efabless/EF_LDOR1V8/README.md

## 1. Description
*  The EF_LDOR1V8 is a positive low dropout regulator for an output of 1.8 V. It is capable of supplying 100 mA of output current with a dropout voltage of 650 mV. A low operating quiescent current of 115 µA is consumed at no load current. Moreover, it provides a standard fixed output voltage of 1.8V which is a good choice for a logic power supply. The EF_LDOR1V8 requires an output capacitance of 47 μF with a wide range of ESR (0.1 Ω to 0.5 Ω) for stability. Output capacitors of this size are typically included in most regulator designs. The functional block diagram is illustrated in Figure 1.

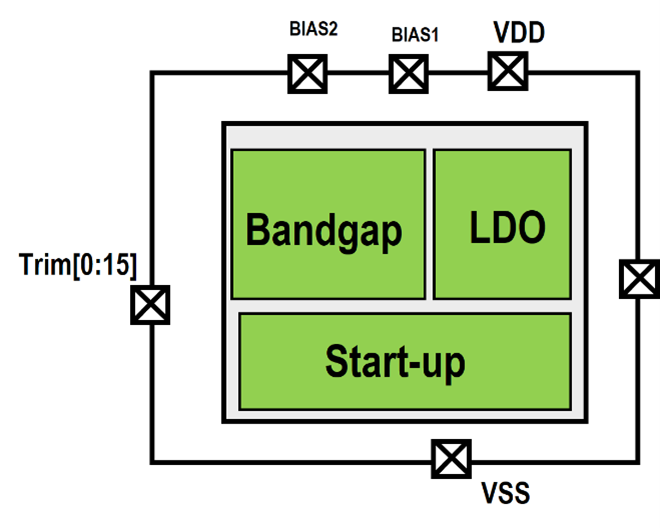
[picture p1: docs/_static/figure1.functional_block_diagram.png]


*Figure 1. Functional Block Diagram*

## 2. Features
* 100mA Output Current Capability.
* Standard Fixed Output Voltage of 1.8 V.
* Low Dropout Voltage: 650 mV at 100 mA.
* Stable with Output Capacitor of 47 µF.
  - CAP ALUM 47UF 20% 35V SMD.
* Low Supply Current of 115 µA (No Load).
* Low-Temperature Coefficient 125 ppm/°C.
* 0.016 V/V Line Regulation at 100 mA.
*	0.0083 mV/mA Load Regulation at 3.3 V.
*	Power Supply Ripple Rejection of 38.9 dB.
*	Startup time of 450 µs at rising time of 100 µs.

## 3. Applications
*	3.3V to 1.8V Logic Power Supply 

## 4. Pin Configuration and Functions

* Corresponding to the Block Diagram of the EF_LDOR1V8, each pin name with its function is described in Table 1. Moreover, a typical application of the EF_LDOR1V8 configuration is presented in Figure 2, where, Co=47µF, ESR=0.1Ω, RB1=450 KΩ, RB2=300 KΩ, and Trim[6]=3.3 V. Min RL is  18 Ω to provide Max load current of 100 mA.

*Table 1. Pin Configuration and Functions*
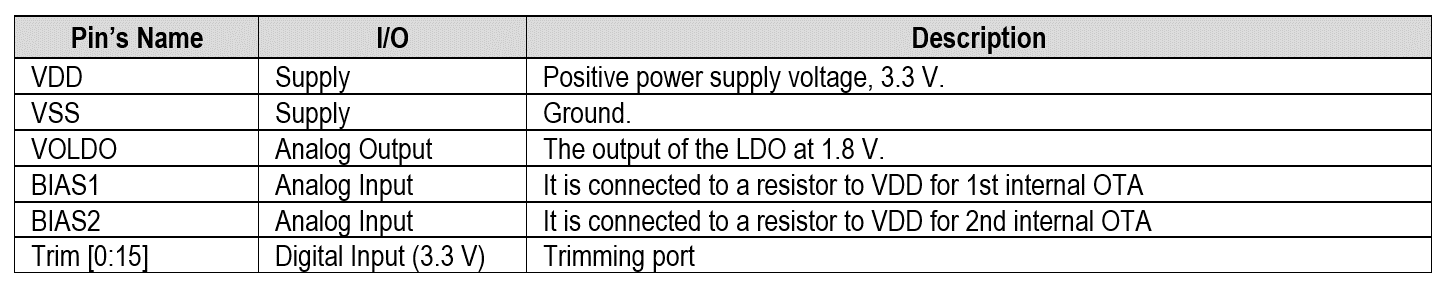
[picture p2: docs/_static/table1.png]


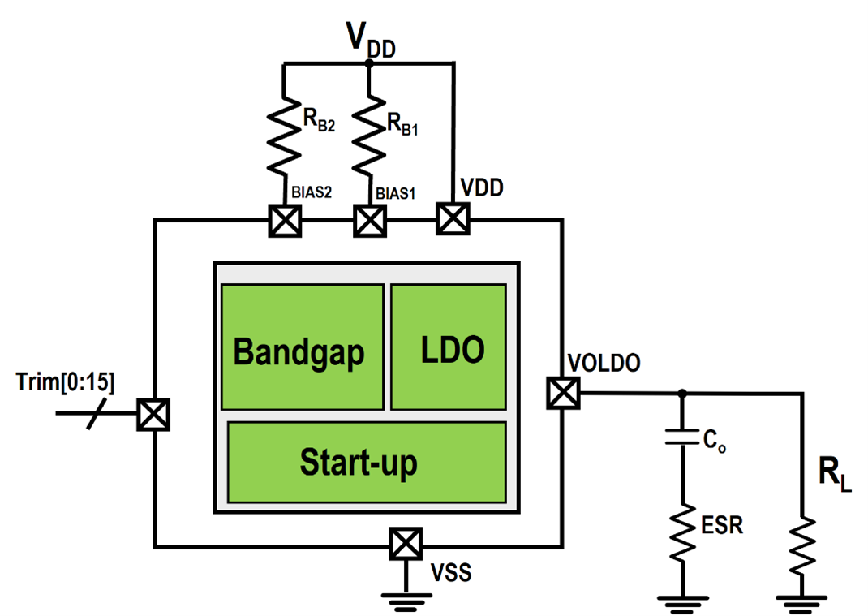
[picture p3: docs/_static/figure2.typical_application.png]


*Figure 2. Typical Application*

## 5. Electrical Characteristics

* The post-layout simulation results of the proposed EF_LDOR1V8 are listed in Table 2. Those parameters are reported at Temp.=27°C,Co=47µF, ESR=0.1Ω, RB1=450 KΩ, RB2=300 KΩ, Trim[6]=3.3 V. 

*Table 2. Electrical Characteristics*
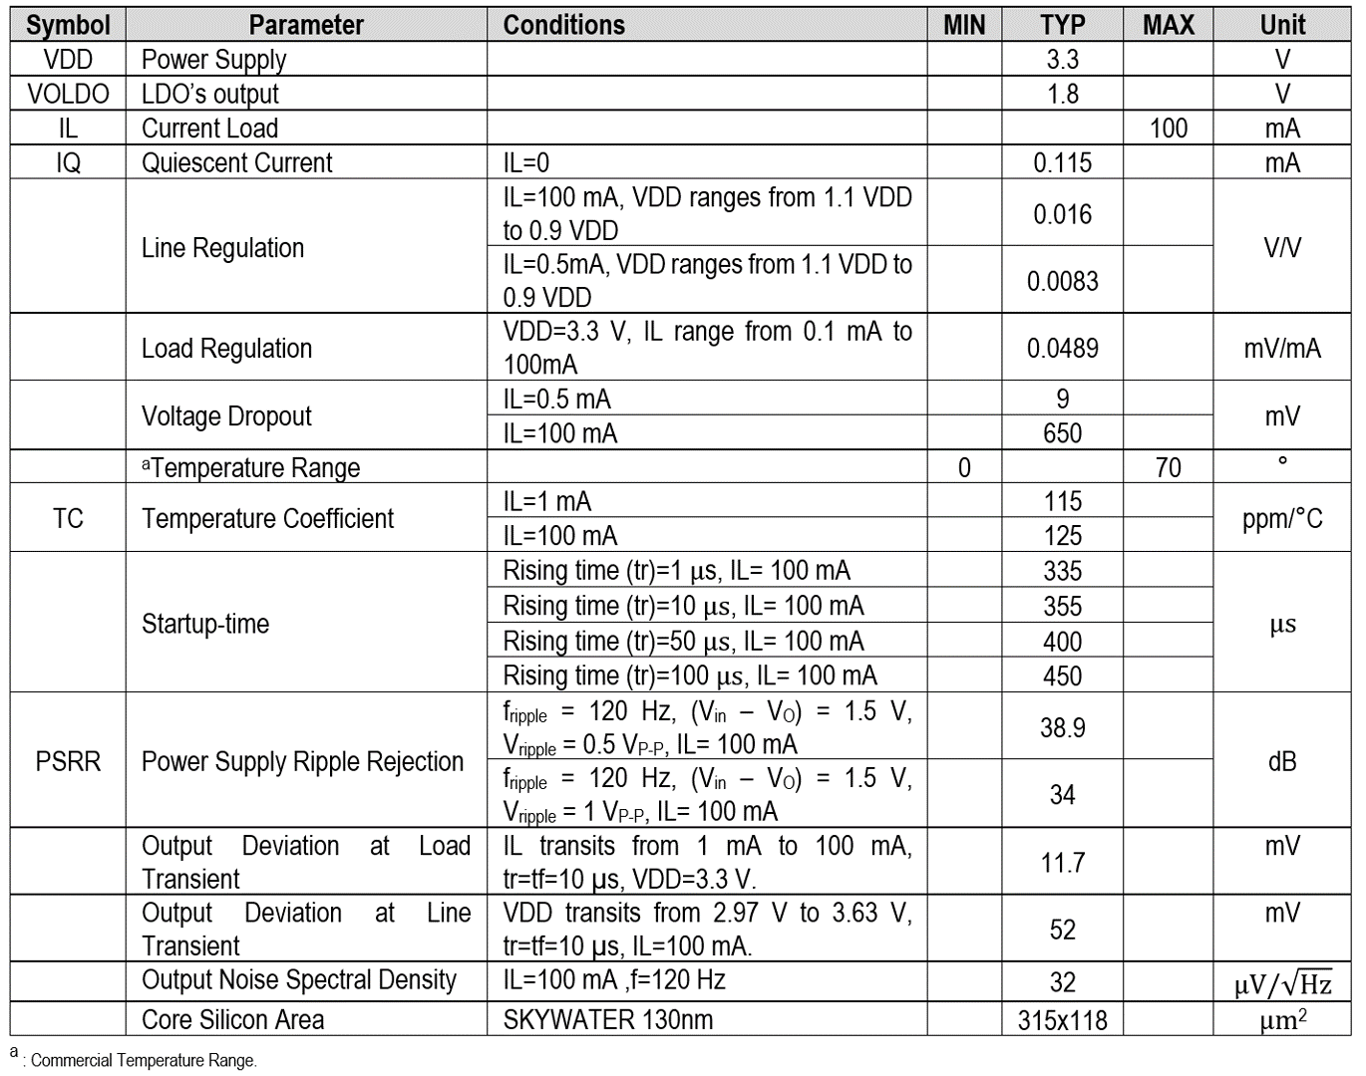
[picture p4: docs/_static/table2.png]


## 6. Typical Performance Curves

* The proposed EF_LDOR1V8 has been designed and simulated using open-source tools with SkyWater technology. Herein, [XSCHEM](https://xschem.sourceforge.io/stefan/index.html) is a schematic capture program that provides a graphical method of the electronic schematic circuit, easily. [NGSPICE](http://ngspice.sourceforge.net/download.html) is an open-source spice simulator. It is exploited to simulate and verify the designed circuit. The layout of the EF_DACR0801 is implemented using [MAGIC 8.3](http://opencircuitdesign.com/magic/) and for design rule check (DRC) as well. However, [NETGEN](http://opencircuitdesign.com/netgen/) is used for comparing netlists of the layout and schematic, known as layout vs schematic (LVS). [PYTHON](https://www.python.org/) can be integrated with the NGSPICE simulator for data manipulation/analysis of the simulation result.

#### Next, typical performance curves of the EF_LDOR1V8 post-layout simulations are presented. 

* As depicted in Figure 3 (a), EF_LDOR1V8's output is plotted by sweeping the input voltage from 0V to 5V at different levels of load currents. Besides, the dropout voltages are calculated at different levels of load currents, then plotted as shown in Figure 3 (b). In Figure 4, Output Voltage vs Input Voltage and Line Regulation vs Load Current are illustrated. Load Regulation can be measured using Figure 5. Startup time and Temperature Coefficient are calculated as shown in Figures 6 and 7, respectively. 

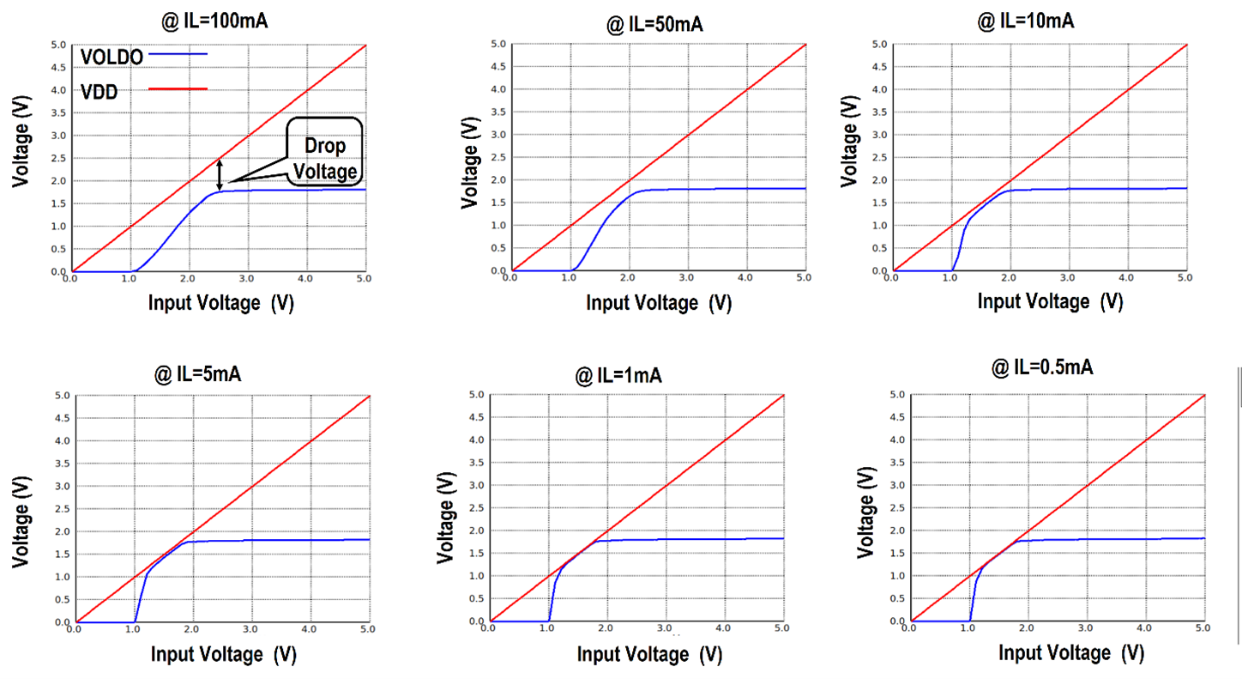
[picture p5: docs/_static/figure3.(a) Output Voltage vs Input Voltage.png]


(a)

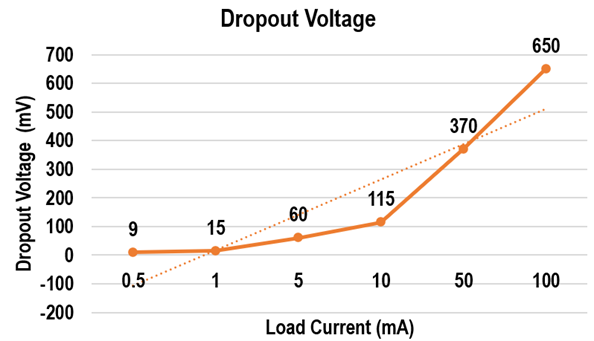
[picture p6: docs/_static/figure3. (b)dropout_voltage_ vs_load current..png]


(b)

*Figure 3. (a) Output Voltage vs Input Voltage, (b) Dropout Voltage vs Load Current.*
 
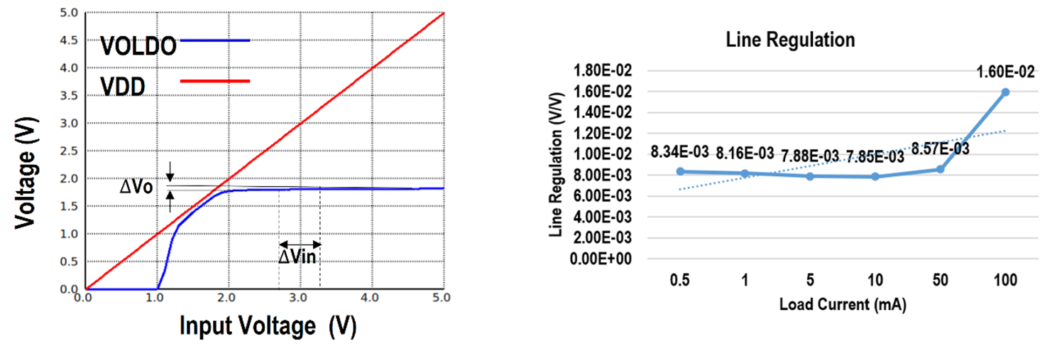
[picture p7: docs/_static/figure4. (a) output-voltage_vs_Input_voltage(b)line_regulation_vs_load_current..png]


                       (a)                                            (b)
                       
*Figure 4. (a) Output Voltage vs Input Voltage, (b) Line Regulation vs Load Current.*

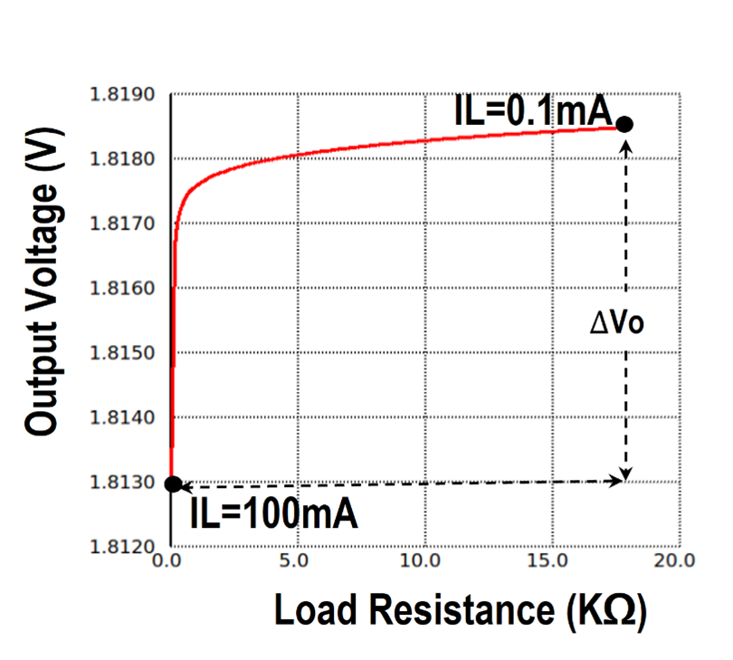
[picture p8: docs/_static/figure 5.output_voltage_vs_load_resistance.png]


*Figure 5.  Output Voltage vs Load Resistance at VDD=3.3V*

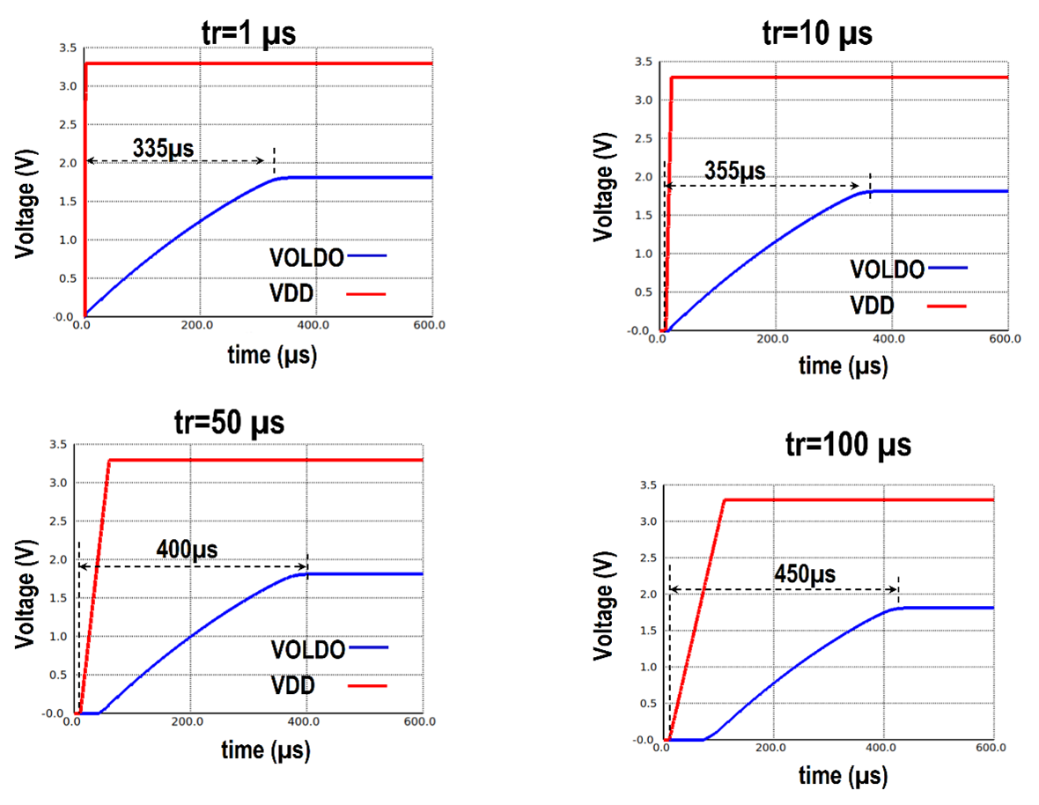
[picture p9: docs/_static/figure6. startup_time.png]


*Figure 6. Startup time at different rising time of input voltage Il=100 mA.*

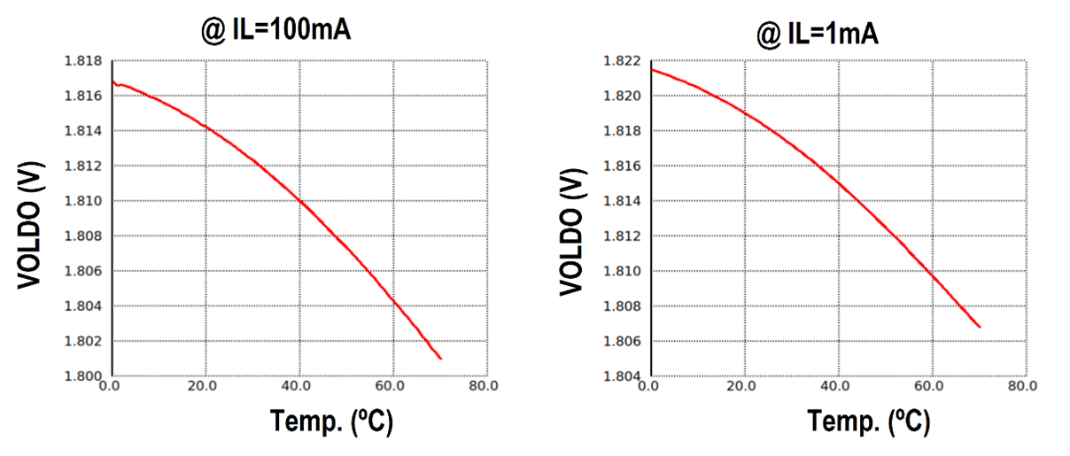
[picture p10: docs/_static/figure7. temperature_coefficient.png]


*Figure 7. Temperature Coefficient of the output voltage at (a) IL=100 mA, and (b) IL=1 mA*

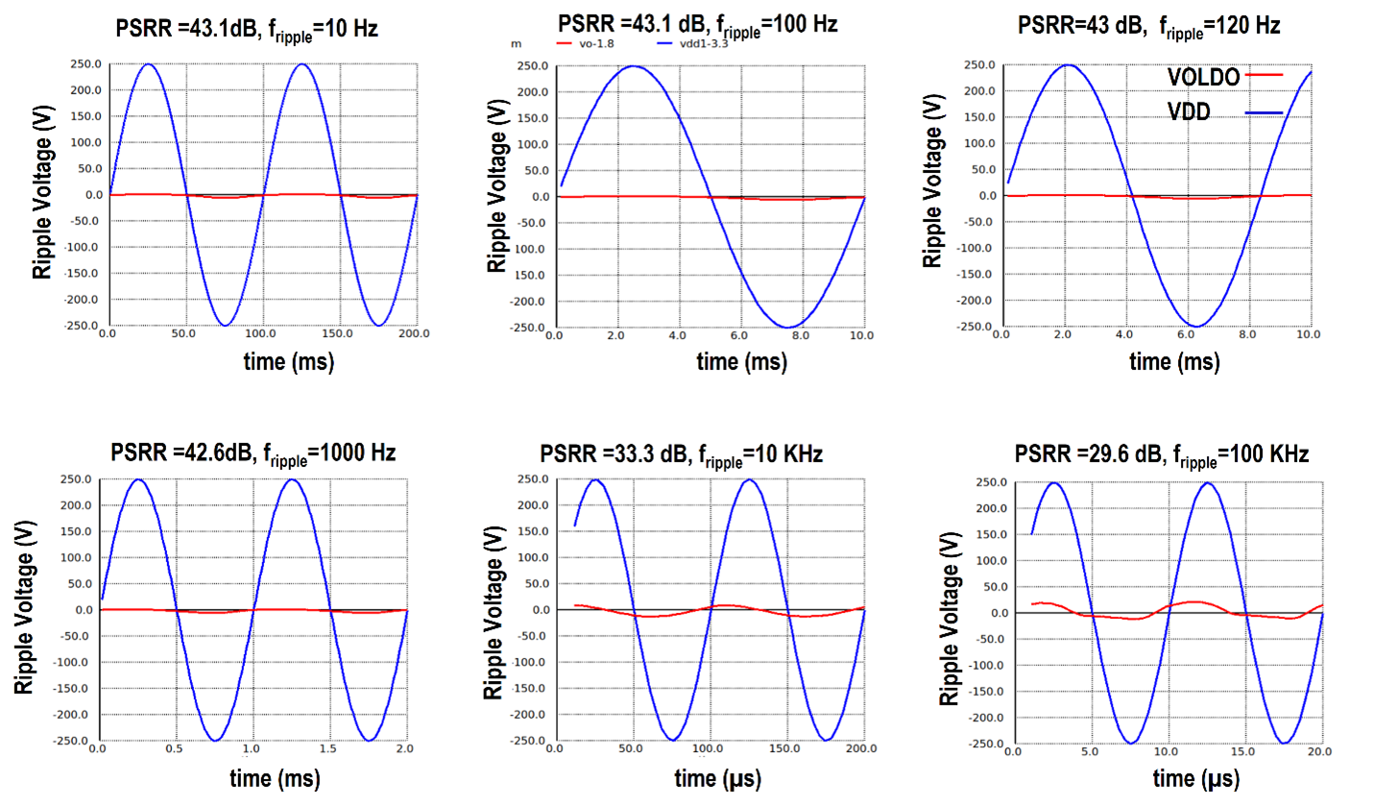
[picture p11: docs/_static/figure 8.ripple_voltage.png]


(a)

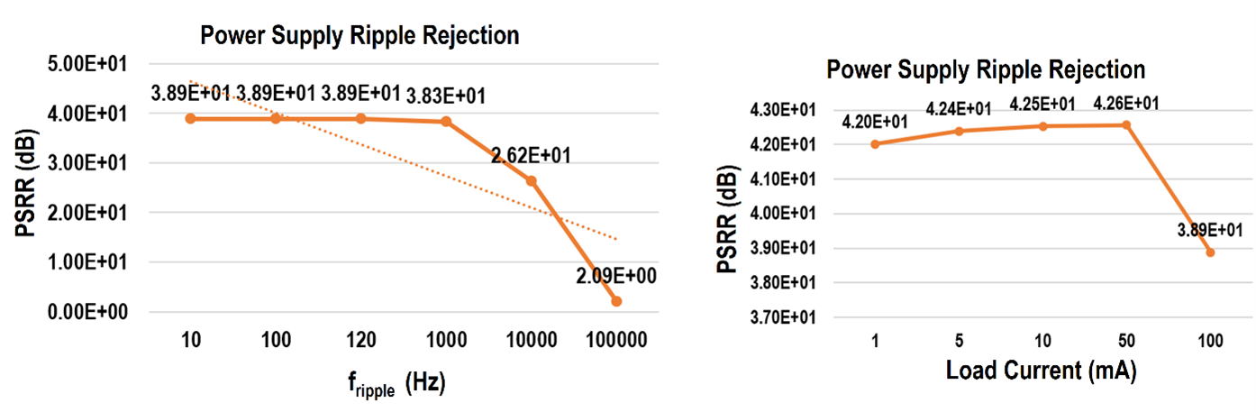
[picture p12: docs/_static/figure8. (b)psrr_vs_frequency (c)psrr_load_current.png]


                       (b)                                            (c)

*Figure 8. (a) Ripple Voltage at Vp-p=0.5 V , (b) PSRR vs Frequency at IL=100 mA, (c) PSRR Vs Load current at fripple=120 Hz and Vp-p=0.5 V*

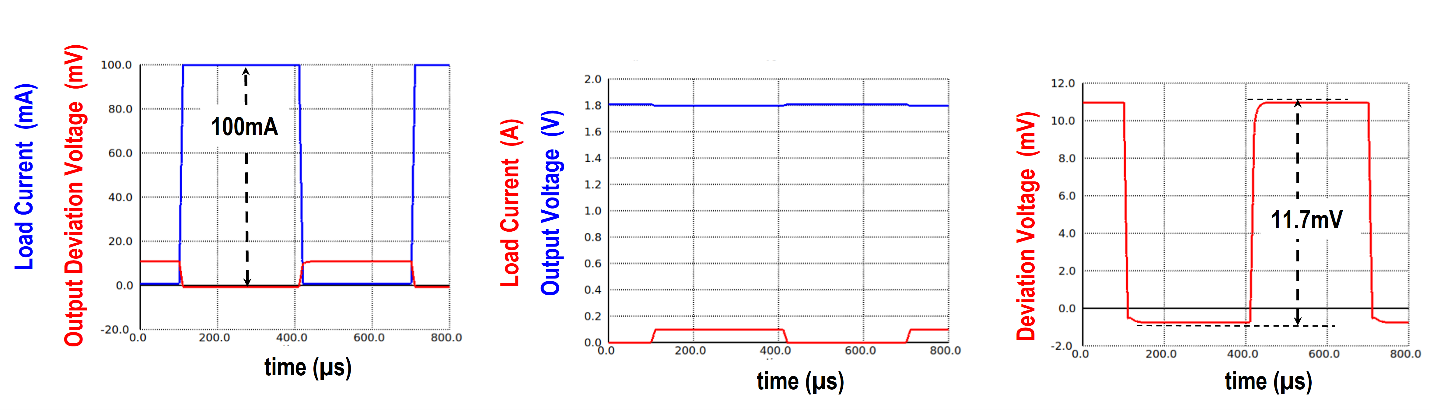
[picture p13: docs/_static/figure 9.load_transient_response.png]


*Figure 9. Load Transient Response at VDD of 3.3 V (tr=tf=10μs).*

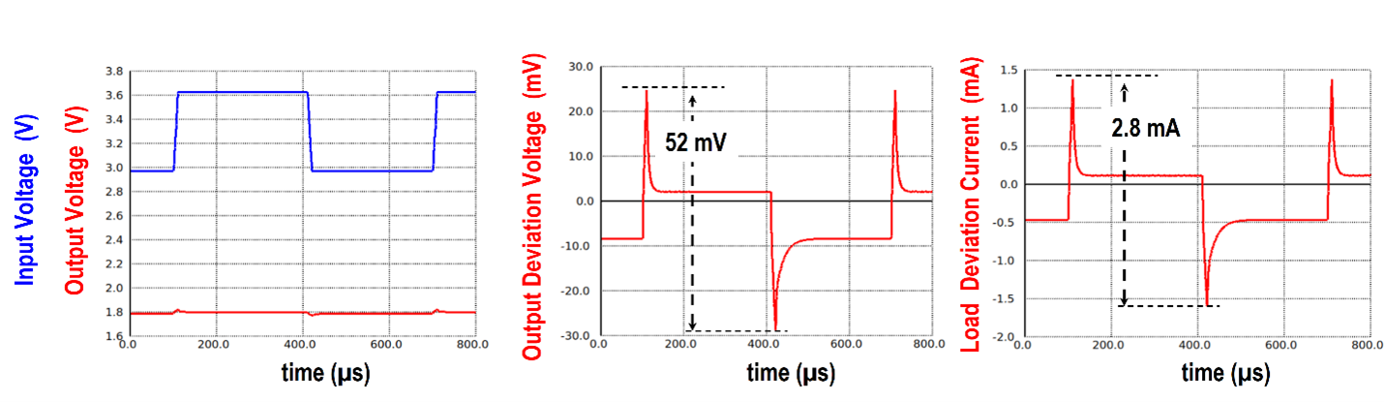
[picture p14: docs/_static/figure10.line_transient_response.png]


*Figure 10. Line Transient Response at IL of 100 mA and VDD transits from 2.97 V to 3.63 V.*

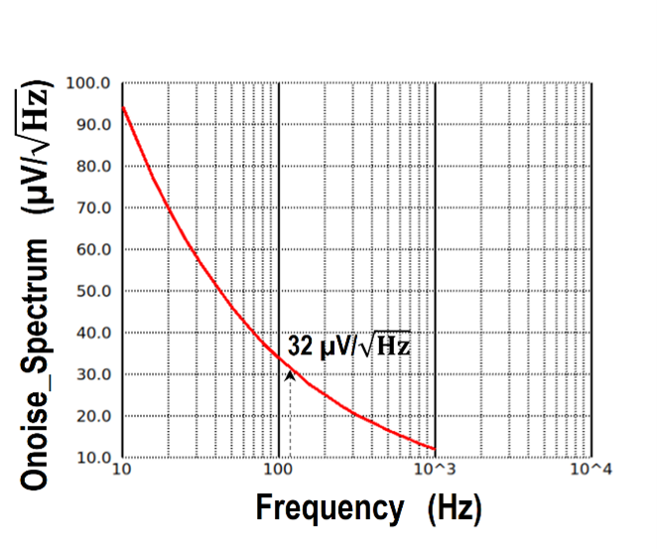
[picture p15: docs/_static/figure 11.output_noise_spectrum.png]


*Figure 11. Output Noise Spectrum*

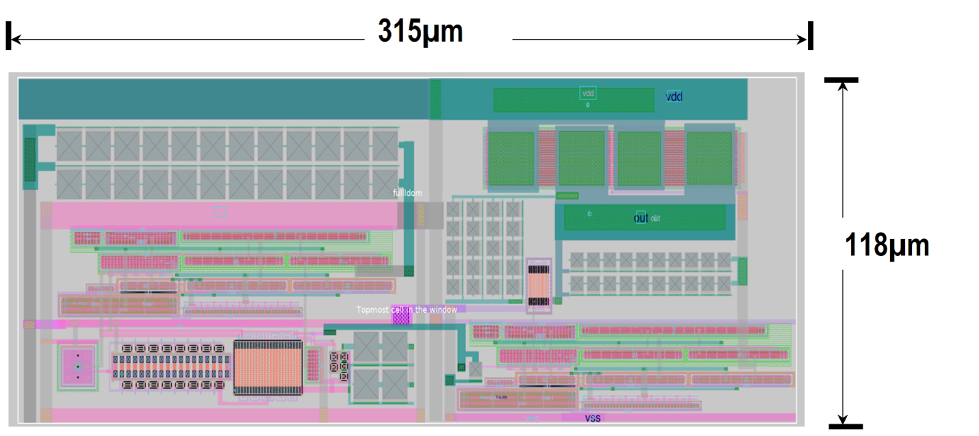
[picture p16: docs/_static/figure12.full_regulator_layout.png]


*Figure 12. Full Regulator Layout*

## 7. Downloading the files on your System
<p>&nbsp;</p>

* The files from this repository can be downloaded and used by the following commands:-
>`sudo apt install -y git`

>`git clone https://github.com/Ahmedredamohamed2022/EF_LDOR01.git`

<p>&nbsp;</p>
