efabless/EF_LDOR1V8/spice/readme.md

* Here, lvs folder contains two spice files:
  - The extracted spice file from the layout titled "EF_LDOR01f.spice" 
  - The extracted spice file from the XSCHEM  titled "EF_LDOR01f.spice" 
* In the post_layout folder, the extracted spice file from the layout with RC is attached.
* In the pre_layout folder, the extracted spice file from the XSCHEM  is included.
