efabless/EF_LDOR1V8/characterization/temperature_coefficient/readme.md

## To run the temperature coefficient testbench using the follwing steps:-
* Open terminal window
* Write the next command 
<p>&nbsp;</p>

>`ngspice tc.spice`

<p>&nbsp;</p>
