efabless/EF_LDOR1V8/characterization/startup/readme.md

## To run the start_up testbench using the follwing steps:-
* Open terminal window
* Write the next command 
<p>&nbsp;</p>

>`ngspice startup.spice`

<p>&nbsp;</p>
