efabless/EF_LDOR1V8/characterization/power_suppy_ripple_rejection/readme.md

## To run the PSRR testbench using the follwing steps:-
* Open terminal window
* Write the next command 
<p>&nbsp;</p>

>`ngspice psrr.spice`

<p>&nbsp;</p>
