efabless/EF_LDOR1V8/characterization/noise/readme.md

## To run the noise testbench using the follwing steps:-
* Open terminal window
* Write the next command 
<p>&nbsp;</p>

>`ngspice noise.spice`

<p>&nbsp;</p>
