efabless/EF_LDOR1V8/characterization/load_transient/readme.md

## To run the load_transient testbench using the follwing steps:-
* Open terminal window
* Write the next command 
<p>&nbsp;</p>

>`ngspice load_trans.spice`

<p>&nbsp;</p>
