efabless/EF_LDOR1V8/characterization/line_transient/readme.md

## To run the line_transient testbench using the follwing steps:-
* Open terminal window
* Write the next command 
<p>&nbsp;</p>

>`ngspice line_trans.spice`

<p>&nbsp;</p>
