efabless/EF_LDOR1V8/verification/load_regulation/loadreg.spice

** sch_path: /home/ahmedreda/Project/AR_BGR/testbench/full_ldo/fullldox_v2-tb/loadreg.sch
**.subckt loadreg
vdd1 vdd1 vss 3.3
.save i(vdd1)
vss2 vss GND 0
.save i(vss2)
Vbias net1 biasbgr 0
.save i(vbias)
vtot vdd1 vdd 0
.save i(vtot)
R3 net4 vdd 300000 m=1
C3 vo net2 47u m=1
R4 net2 vss 0.1 m=1
Vl net3 vss 0
.save i(vl)
Vbiasldo net4 biasldo 0
.save i(vbiasldo)
R2 net1 vdd 450000 m=1
x1 vss vss vss vss vss vss vss vss vss vdd vss vss vss vss vss vss vss biasbgr vdd biasldo vo
+ fullldoxcc
R1 vo net3 0.1 m=1
**** begin user architecture code



.options RSHUNT=1e15
.options savecurrents
.option TEMP=27
.option TNOM=27

.control
**set filetype=binary
set filetype=ascii
set color0=white
set color1=black
set color3=blue
set xbrushwidth=3
run
save all
dc R1 18 18000 100
plot vo vdd vbg
plot vo
plot vbg
meas DC vo1 FIND vo AT=18
meas DC vo2 FIND vo AT=1800
let loadReg= mag(vo1-vo2)*1000/99
print loadReg


.endc





.lib /home/ahmedreda/PDK/sky130A/libs.tech/ngspice/sky130.lib.spice tt


**** end user architecture code
**.ends

* expanding   symbol:  Project/AR_BGR/schematic/fullldo/fullldoxcc.sym # of pins=6
** sym_path: /home/ahmedreda/Project/AR_BGR/schematic/fullldo/fullldoxcc.sym
** sch_path: /home/ahmedreda/Project/AR_BGR/schematic/fullldo/fullldoxcc.sch
.subckt fullldoxcc trim[15] trim[14] trim[13] trim[12] trim[11] trim[10] trim[9] trim[8] trim[7]
+ trim[6] trim[5] trim[4] trim[3] trim[2] trim[1] trim[0] vss biasbgr vdd biasldo out
*.iopin vss
*.iopin vdd
*.ipin biasldo
*.opin out
*.ipin biasbgr
*.ipin
*+ trim[15],trim[14],trim[13],trim[12],trim[11],trim[10],trim[9],trim[8],trim[7],trim[6],trim[5],trim[4],trim[3],trim[2],trim[1],trim[0]
x1 vss vdd biasldo vref out ldoxc
x2 vdd vref vss biasbgr trim[15] trim[14] trim[13] trim[12] trim[11] trim[10] trim[9] trim[8]
+ trim[7] trim[6] trim[5] trim[4] trim[3] trim[2] trim[1] trim[0] gate bandgapxd
XC2 gate vss sky130_fd_pr__cap_mim_m3_1 W=10 L=10 MF=24 m=24
XC1 vref vss sky130_fd_pr__cap_mim_m3_1 W=5 L=5 MF=1 m=1
.ends


* expanding   symbol:  Project/AR_BGR/schematic/ldo_core/ldoxc.sym # of pins=5
** sym_path: /home/ahmedreda/Project/AR_BGR/schematic/ldo_core/ldoxc.sym
** sch_path: /home/ahmedreda/Project/AR_BGR/schematic/ldo_core/ldoxc.sch
.subckt ldoxc vss vdd bias vref out
*.opin out
*.ipin bias
*.iopin vss
*.iopin vdd
*.ipin vref
x3 vdd vg out pmosx
x1 vdd vg vref fbdiv bias vss otaldox
x2 out vss fbdiv vdx
XC4 vg out sky130_fd_pr__cap_mim_m3_1 W=5 L=5 MF=20 m=20
XC5 out fbdiv sky130_fd_pr__cap_mim_m3_1 W=5 L=5 MF=20 m=20
.ends


* expanding   symbol:  Project/AR_BGR/schematic/bandgap_core/bandgapxd.sym # of pins=6
** sym_path: /home/ahmedreda/Project/AR_BGR/schematic/bandgap_core/bandgapxd.sym
** sch_path: /home/ahmedreda/Project/AR_BGR/schematic/bandgap_core/bandgapxd.sch
.subckt bandgapxd vdd vbg vss bias trim[15] trim[14] trim[13] trim[12] trim[11] trim[10] trim[9]
+ trim[8] trim[7] trim[6] trim[5] trim[4] trim[3] trim[2] trim[1] trim[0] gate
*.opin vbg
*.ipin bias
*.ipin
*+ trim[15],trim[14],trim[13],trim[12],trim[11],trim[10],trim[9],trim[8],trim[7],trim[6],trim[5],trim[4],trim[3],trim[2],trim[1],trim[0]
*.iopin vdd
*.iopin vss
*.opin gate
XM12 comp gate vdd vdd sky130_fd_pr__pfet_g5v0d10v5 L=1 W=4 nf=1 ad='int((nf+1)/2) * W/nf * 0.29' as='int((nf+2)/2) * W/nf * 0.29'
+ pd='2*int((nf+1)/2) * (W/nf + 0.29)' ps='2*int((nf+2)/2) * (W/nf + 0.29)' nrd='0.29 / W' nrs='0.29 / W'
+ sa=0 sb=0 sd=0 mult=2 m=2
XM1 vbg gate vdd vdd sky130_fd_pr__pfet_g5v0d10v5 L=1 W=4 nf=1 ad='int((nf+1)/2) * W/nf * 0.29' as='int((nf+2)/2) * W/nf * 0.29'
+ pd='2*int((nf+1)/2) * (W/nf + 0.29)' ps='2*int((nf+2)/2) * (W/nf + 0.29)' nrd='0.29 / W' nrs='0.29 / W'
+ sa=0 sb=0 sd=0 mult=2 m=2
XM2 vs2 vs2 vdd vdd sky130_fd_pr__pfet_g5v0d10v5 L=1 W=1 nf=1 ad='int((nf+1)/2) * W/nf * 0.29' as='int((nf+2)/2) * W/nf * 0.29'
+ pd='2*int((nf+1)/2) * (W/nf + 0.29)' ps='2*int((nf+2)/2) * (W/nf + 0.29)' nrd='0.29 / W' nrs='0.29 / W'
+ sa=0 sb=0 sd=0 mult=1 m=1
XM6 vss vdd vs2 vdd sky130_fd_pr__pfet_g5v0d10v5 L=1 W=1 nf=1 ad='int((nf+1)/2) * W/nf * 0.29' as='int((nf+2)/2) * W/nf * 0.29'
+ pd='2*int((nf+1)/2) * (W/nf + 0.29)' ps='2*int((nf+2)/2) * (W/nf + 0.29)' nrd='0.29 / W' nrs='0.29 / W'
+ sa=0 sb=0 sd=0 mult=1 m=1
XC2 vs2 vss sky130_fd_pr__cap_mim_m3_1 W=10 L=10 MF=4 m=4
XM3 vs1 vbg vss vss sky130_fd_pr__nfet_g5v0d10v5 L=1 W=1 nf=1 ad='int((nf+1)/2) * W/nf * 0.29' as='int((nf+2)/2) * W/nf * 0.29'
+ pd='2*int((nf+1)/2) * (W/nf + 0.29)' ps='2*int((nf+2)/2) * (W/nf + 0.29)' nrd='0.29 / W' nrs='0.29 / W'
+ sa=0 sb=0 sd=0 mult=1 m=1
XM4 gate vs1 vss vss sky130_fd_pr__nfet_g5v0d10v5 L=1 W=1 nf=1 ad='int((nf+1)/2) * W/nf * 0.29' as='int((nf+2)/2) * W/nf * 0.29'
+ pd='2*int((nf+1)/2) * (W/nf + 0.29)' ps='2*int((nf+2)/2) * (W/nf + 0.29)' nrd='0.29 / W' nrs='0.29 / W'
+ sa=0 sb=0 sd=0 mult=1 m=1
x2 vbg comp vp vn vss bg_res
x3 trimup veg trim[15] trim[14] trim[13] trim[12] trim[11] trim[10] trim[9] trim[8] trim[7] trim[6]
+ trim[5] trim[4] trim[3] trim[2] trim[1] trim[0] vss bg_trim
XQ1 vss vss vn sky130_fd_pr__pnp_05v5_W0p68L0p68 m=1
XQ2 vss vss veg sky130_fd_pr__pnp_05v5_W0p68L0p68 m=8
x7 vdd gate vp vn vss bias ota
XR2 trimup vp vss sky130_fd_pr__res_xhigh_po_0p69 L=13 mult=1 m=1
XM7 vdd vdd vdd vdd sky130_fd_pr__pfet_g5v0d10v5 L=1 W=4 nf=1 ad='int((nf+1)/2) * W/nf * 0.29' as='int((nf+2)/2) * W/nf * 0.29'
+ pd='2*int((nf+1)/2) * (W/nf + 0.29)' ps='2*int((nf+2)/2) * (W/nf + 0.29)' nrd='0.29 / W' nrs='0.29 / W'
+ sa=0 sb=0 sd=0 mult=4 m=4
XR17 vss vss vss sky130_fd_pr__res_high_po W=1.41 L=2.8 mult=1 m=1
XR18 vss vss vss sky130_fd_pr__res_high_po W=1.41 L=2.8 mult=1 m=1
XR21 vss vss vss sky130_fd_pr__res_xhigh_po_0p69 L=13 mult=1 m=1
XR23 vss vss vss sky130_fd_pr__res_xhigh_po_0p69 L=13 mult=1 m=1
XM5 vs1 vs2 vdd vdd sky130_fd_pr__pfet_g5v0d10v5 L=1 W=1 nf=1 ad='int((nf+1)/2) * W/nf * 0.29' as='int((nf+2)/2) * W/nf * 0.29'
+ pd='2*int((nf+1)/2) * (W/nf + 0.29)' ps='2*int((nf+2)/2) * (W/nf + 0.29)' nrd='0.29 / W' nrs='0.29 / W'
+ sa=0 sb=0 sd=0 mult=1 m=1
.ends


* expanding   symbol:  Project/AR_BGR/schematic/ldo_core/pmosx.sym # of pins=3
** sym_path: /home/ahmedreda/Project/AR_BGR/schematic/ldo_core/pmosx.sym
** sch_path: /home/ahmedreda/Project/AR_BGR/schematic/ldo_core/pmosx.sch
.subckt pmosx vdd vg vout
*.opin vout
*.iopin vdd
*.ipin vg
XM8 vout vg vdd vdd sky130_fd_pr__pfet_g5v0d10v5 L=0.5 W=50 nf=1 ad='int((nf+1)/2) * W/nf * 0.29' as='int((nf+2)/2) * W/nf * 0.29'
+ pd='2*int((nf+1)/2) * (W/nf + 0.29)' ps='2*int((nf+2)/2) * (W/nf + 0.29)' nrd='0.29 / W' nrs='0.29 / W'
+ sa=0 sb=0 sd=0 mult=44 m=44
XM1 vdd vdd vdd vdd sky130_fd_pr__pfet_g5v0d10v5 L=0.5 W=50 nf=1 ad='int((nf+1)/2) * W/nf * 0.29' as='int((nf+2)/2) * W/nf * 0.29'
+ pd='2*int((nf+1)/2) * (W/nf + 0.29)' ps='2*int((nf+2)/2) * (W/nf + 0.29)' nrd='0.29 / W' nrs='0.29 / W'
+ sa=0 sb=0 sd=0 mult=4 m=4
.ends


* expanding   symbol:  Project/AR_BGR/schematic/ldo_core/otaldox.sym # of pins=6
** sym_path: /home/ahmedreda/Project/AR_BGR/schematic/ldo_core/otaldox.sym
** sch_path: /home/ahmedreda/Project/AR_BGR/schematic/ldo_core/otaldox.sch
.subckt otaldox vdd otaout vref fbdiv bias vss
*.ipin vref
*.ipin bias
*.iopin vss
*.iopin vdd
*.ipin fbdiv
*.opin otaout
XM12 vbp1 vbp1 vdd vdd sky130_fd_pr__pfet_g5v0d10v5 L=1 W=4 nf=1 ad='int((nf+1)/2) * W/nf * 0.29' as='int((nf+2)/2) * W/nf * 0.29'
+ pd='2*int((nf+1)/2) * (W/nf + 0.29)' ps='2*int((nf+2)/2) * (W/nf + 0.29)' nrd='0.29 / W' nrs='0.29 / W'
+ sa=0 sb=0 sd=0 mult=4 m=4
XM13 vbn2 vbp1 vdd vdd sky130_fd_pr__pfet_g5v0d10v5 L=1 W=4 nf=1 ad='int((nf+1)/2) * W/nf * 0.29' as='int((nf+2)/2) * W/nf * 0.29'
+ pd='2*int((nf+1)/2) * (W/nf + 0.29)' ps='2*int((nf+2)/2) * (W/nf + 0.29)' nrd='0.29 / W' nrs='0.29 / W'
+ sa=0 sb=0 sd=0 mult=4 m=4
XM14 bias1 bias1 vbp1 vdd sky130_fd_pr__pfet_g5v0d10v5 L=1 W=4 nf=1 ad='int((nf+1)/2) * W/nf * 0.29'
+ as='int((nf+2)/2) * W/nf * 0.29' pd='2*int((nf+1)/2) * (W/nf + 0.29)' ps='2*int((nf+2)/2) * (W/nf + 0.29)'
+ nrd='0.29 / W' nrs='0.29 / W' sa=0 sb=0 sd=0 mult=4 m=4
XM6 outp fbdiv diff vdd sky130_fd_pr__pfet_g5v0d10v5 L=1 W=4 nf=1 ad='int((nf+1)/2) * W/nf * 0.29' as='int((nf+2)/2) * W/nf * 0.29'
+ pd='2*int((nf+1)/2) * (W/nf + 0.29)' ps='2*int((nf+2)/2) * (W/nf + 0.29)' nrd='0.29 / W' nrs='0.29 / W'
+ sa=0 sb=0 sd=0 mult=10 m=10
XM10 diff vbp1 vdd vdd sky130_fd_pr__pfet_g5v0d10v5 L=1 W=4 nf=1 ad='int((nf+1)/2) * W/nf * 0.29' as='int((nf+2)/2) * W/nf * 0.29'
+ pd='2*int((nf+1)/2) * (W/nf + 0.29)' ps='2*int((nf+2)/2) * (W/nf + 0.29)' nrd='0.29 / W' nrs='0.29 / W'
+ sa=0 sb=0 sd=0 mult=10 m=10
XM11 o1 vg vdd vdd sky130_fd_pr__pfet_g5v0d10v5 L=4 W=2 nf=1 ad='int((nf+1)/2) * W/nf * 0.29' as='int((nf+2)/2) * W/nf * 0.29'
+ pd='2*int((nf+1)/2) * (W/nf + 0.29)' ps='2*int((nf+2)/2) * (W/nf + 0.29)' nrd='0.29 / W' nrs='0.29 / W'
+ sa=0 sb=0 sd=0 mult=8 m=8
XM15 o2 vg vdd vdd sky130_fd_pr__pfet_g5v0d10v5 L=4 W=2 nf=1 ad='int((nf+1)/2) * W/nf * 0.29' as='int((nf+2)/2) * W/nf * 0.29'
+ pd='2*int((nf+1)/2) * (W/nf + 0.29)' ps='2*int((nf+2)/2) * (W/nf + 0.29)' nrd='0.29 / W' nrs='0.29 / W'
+ sa=0 sb=0 sd=0 mult=8 m=8
XM16 otaout bias1 o2 vdd sky130_fd_pr__pfet_g5v0d10v5 L=4 W=2 nf=1 ad='int((nf+1)/2) * W/nf * 0.29' as='int((nf+2)/2) * W/nf * 0.29'
+ pd='2*int((nf+1)/2) * (W/nf + 0.29)' ps='2*int((nf+2)/2) * (W/nf + 0.29)' nrd='0.29 / W' nrs='0.29 / W'
+ sa=0 sb=0 sd=0 mult=8 m=8
XM17 vg bias1 o1 vdd sky130_fd_pr__pfet_g5v0d10v5 L=4 W=2 nf=1 ad='int((nf+1)/2) * W/nf * 0.29' as='int((nf+2)/2) * W/nf * 0.29'
+ pd='2*int((nf+1)/2) * (W/nf + 0.29)' ps='2*int((nf+2)/2) * (W/nf + 0.29)' nrd='0.29 / W' nrs='0.29 / W'
+ sa=0 sb=0 sd=0 mult=8 m=8
XM19 vbn2 vbn2 vbn1 vss sky130_fd_pr__nfet_g5v0d10v5 L=4 W=2 nf=1 ad='int((nf+1)/2) * W/nf * 0.29' as='int((nf+2)/2) * W/nf * 0.29'
+ pd='2*int((nf+1)/2) * (W/nf + 0.29)' ps='2*int((nf+2)/2) * (W/nf + 0.29)' nrd='0.29 / W' nrs='0.29 / W'
+ sa=0 sb=0 sd=0 mult=4 m=4
XM18 vg vbn2 outp vss sky130_fd_pr__nfet_g5v0d10v5 L=4 W=2 nf=1 ad='int((nf+1)/2) * W/nf * 0.29' as='int((nf+2)/2) * W/nf * 0.29'
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
XM35 vg vg vg vdd sky130_fd_pr__pfet_g5v0d10v5 L=1 W=2 nf=1 ad='int((nf+1)/2) * W/nf * 0.29' as='int((nf+2)/2) * W/nf * 0.29'
+ pd='2*int((nf+1)/2) * (W/nf + 0.29)' ps='2*int((nf+2)/2) * (W/nf + 0.29)' nrd='0.29 / W' nrs='0.29 / W'
+ sa=0 sb=0 sd=0 mult=4 m=4
XM36 otaout otaout otaout vdd sky130_fd_pr__pfet_g5v0d10v5 L=1 W=2 nf=1 ad='int((nf+1)/2) * W/nf * 0.29'
+ as='int((nf+2)/2) * W/nf * 0.29' pd='2*int((nf+1)/2) * (W/nf + 0.29)' ps='2*int((nf+2)/2) * (W/nf + 0.29)'
+ nrd='0.29 / W' nrs='0.29 / W' sa=0 sb=0 sd=0 mult=4 m=4
XM37 otaout otaout otaout vss sky130_fd_pr__nfet_g5v0d10v5 L=1 W=2 nf=1 ad='int((nf+1)/2) * W/nf * 0.29'
+ as='int((nf+2)/2) * W/nf * 0.29' pd='2*int((nf+1)/2) * (W/nf + 0.29)' ps='2*int((nf+2)/2) * (W/nf + 0.29)'
+ nrd='0.29 / W' nrs='0.29 / W' sa=0 sb=0 sd=0 mult=4 m=4
XM38 vg vg vg vss sky130_fd_pr__nfet_g5v0d10v5 L=1 W=2 nf=1 ad='int((nf+1)/2) * W/nf * 0.29' as='int((nf+2)/2) * W/nf * 0.29'
+ pd='2*int((nf+1)/2) * (W/nf + 0.29)' ps='2*int((nf+2)/2) * (W/nf + 0.29)' nrd='0.29 / W' nrs='0.29 / W'
+ sa=0 sb=0 sd=0 mult=4 m=4
.ends


* expanding   symbol:  Project/AR_BGR/schematic/ldo_core/vdx.sym # of pins=3
** sym_path: /home/ahmedreda/Project/AR_BGR/schematic/ldo_core/vdx.sym
** sch_path: /home/ahmedreda/Project/AR_BGR/schematic/ldo_core/vdx.sch
.subckt vdx vout vss vb
*.opin vout
*.iopin vss
*.opin vb
XR1 vb vout vss sky130_fd_pr__res_xhigh_po W=0.35 L=34 mult=1 m=1
XR2 vss vb vss sky130_fd_pr__res_xhigh_po W=0.35 L=34 mult=1 m=1
XR3 vss vss vss sky130_fd_pr__res_xhigh_po W=0.35 L=8.5 mult=1 m=1
XR4 vss vss vss sky130_fd_pr__res_xhigh_po W=0.35 L=8.5 mult=1 m=1
XR5 vb vout vss sky130_fd_pr__res_xhigh_po W=0.35 L=34 mult=1 m=1
.ends


* expanding   symbol:  Project/AR_BGR/schematic/bandgap_core/bg_res.sym # of pins=5
** sym_path: /home/ahmedreda/Project/AR_BGR/schematic/bandgap_core/bg_res.sym
** sch_path: /home/ahmedreda/Project/AR_BGR/schematic/bandgap_core/bg_res.sch
.subckt bg_res b a d c vss
*.iopin vss
*.ipin a
*.ipin b
*.opin c
*.opin d
XR21 net14 b vss sky130_fd_pr__res_xhigh_po_0p69 L=13 mult=1 m=1
XR1 net15 net14 vss sky130_fd_pr__res_xhigh_po_0p69 L=13 mult=1 m=1
XR2 net16 net15 vss sky130_fd_pr__res_xhigh_po_0p69 L=13 mult=1 m=1
XR3 net17 net16 vss sky130_fd_pr__res_xhigh_po_0p69 L=13 mult=1 m=1
XR4 net18 net17 vss sky130_fd_pr__res_xhigh_po_0p69 L=13 mult=1 m=1
XR5 net6 net18 vss sky130_fd_pr__res_xhigh_po_0p69 L=13 mult=1 m=1
XR6 net8 net6 vss sky130_fd_pr__res_xhigh_po_0p69 L=13 mult=1 m=1
XR7 net10 net8 vss sky130_fd_pr__res_xhigh_po_0p69 L=13 mult=1 m=1
XR8 net12 net10 vss sky130_fd_pr__res_xhigh_po_0p69 L=13 mult=1 m=1
XR9 d net12 vss sky130_fd_pr__res_xhigh_po_0p69 L=13 mult=1 m=1
XR10 c net13 vss sky130_fd_pr__res_xhigh_po_0p69 L=13 mult=1 m=1
XR11 net13 net11 vss sky130_fd_pr__res_xhigh_po_0p69 L=13 mult=1 m=1
XR12 net7 net4 vss sky130_fd_pr__res_xhigh_po_0p69 L=13 mult=1 m=1
XR13 net9 net7 vss sky130_fd_pr__res_xhigh_po_0p69 L=13 mult=1 m=1
XR14 net11 net9 vss sky130_fd_pr__res_xhigh_po_0p69 L=13 mult=1 m=1
XR15 net4 net5 vss sky130_fd_pr__res_xhigh_po_0p69 L=13 mult=1 m=1
XR16 net5 net2 vss sky130_fd_pr__res_xhigh_po_0p69 L=13 mult=1 m=1
XR17 net2 net3 vss sky130_fd_pr__res_xhigh_po_0p69 L=13 mult=1 m=1
XR18 net3 net1 vss sky130_fd_pr__res_xhigh_po_0p69 L=13 mult=1 m=1
XR19 net1 a vss sky130_fd_pr__res_xhigh_po_0p69 L=13 mult=1 m=1
.ends


* expanding   symbol:  Project/AR_BGR/schematic/bandgap_core/bg_trim.sym # of pins=4
** sym_path: /home/ahmedreda/Project/AR_BGR/schematic/bandgap_core/bg_trim.sym
** sch_path: /home/ahmedreda/Project/AR_BGR/schematic/bandgap_core/bg_trim.sch
.subckt bg_trim top bot ctl[15] ctl[14] ctl[13] ctl[12] ctl[11] ctl[10] ctl[9] ctl[8] ctl[7] ctl[6]
+ ctl[5] ctl[4] ctl[3] ctl[2] ctl[1] ctl[0] vss
*.iopin vss
*.iopin bot
*.iopin top
*.ipin
*+ ctl[15],ctl[14],ctl[13],ctl[12],ctl[11],ctl[10],ctl[9],ctl[8],ctl[7],ctl[6],ctl[5],ctl[4],ctl[3],ctl[2],ctl[1],ctl[0]
XM1 top ctl[15] bot vss sky130_fd_pr__nfet_g5v0d10v5 L=0.5 W=2 nf=1 ad='int((nf+1)/2) * W/nf * 0.29'
+ as='int((nf+2)/2) * W/nf * 0.29' pd='2*int((nf+1)/2) * (W/nf + 0.29)' ps='2*int((nf+2)/2) * (W/nf + 0.29)'
+ nrd='0.29 / W' nrs='0.29 / W' sa=0 sb=0 sd=0 mult=1 m=1
XM2 net12 ctl[14] bot vss sky130_fd_pr__nfet_g5v0d10v5 L=0.5 W=2 nf=1 ad='int((nf+1)/2) * W/nf * 0.29'
+ as='int((nf+2)/2) * W/nf * 0.29' pd='2*int((nf+1)/2) * (W/nf + 0.29)' ps='2*int((nf+2)/2) * (W/nf + 0.29)'
+ nrd='0.29 / W' nrs='0.29 / W' sa=0 sb=0 sd=0 mult=1 m=1
XM3 net11 ctl[13] bot vss sky130_fd_pr__nfet_g5v0d10v5 L=0.5 W=2 nf=1 ad='int((nf+1)/2) * W/nf * 0.29'
+ as='int((nf+2)/2) * W/nf * 0.29' pd='2*int((nf+1)/2) * (W/nf + 0.29)' ps='2*int((nf+2)/2) * (W/nf + 0.29)'
+ nrd='0.29 / W' nrs='0.29 / W' sa=0 sb=0 sd=0 mult=1 m=1
XM4 net10 ctl[12] bot vss sky130_fd_pr__nfet_g5v0d10v5 L=0.5 W=2 nf=1 ad='int((nf+1)/2) * W/nf * 0.29'
+ as='int((nf+2)/2) * W/nf * 0.29' pd='2*int((nf+1)/2) * (W/nf + 0.29)' ps='2*int((nf+2)/2) * (W/nf + 0.29)'
+ nrd='0.29 / W' nrs='0.29 / W' sa=0 sb=0 sd=0 mult=1 m=1
XM5 net9 ctl[11] bot vss sky130_fd_pr__nfet_g5v0d10v5 L=0.5 W=2 nf=1 ad='int((nf+1)/2) * W/nf * 0.29'
+ as='int((nf+2)/2) * W/nf * 0.29' pd='2*int((nf+1)/2) * (W/nf + 0.29)' ps='2*int((nf+2)/2) * (W/nf + 0.29)'
+ nrd='0.29 / W' nrs='0.29 / W' sa=0 sb=0 sd=0 mult=1 m=1
XM6 net15 ctl[10] bot vss sky130_fd_pr__nfet_g5v0d10v5 L=0.5 W=2 nf=1 ad='int((nf+1)/2) * W/nf * 0.29'
+ as='int((nf+2)/2) * W/nf * 0.29' pd='2*int((nf+1)/2) * (W/nf + 0.29)' ps='2*int((nf+2)/2) * (W/nf + 0.29)'
+ nrd='0.29 / W' nrs='0.29 / W' sa=0 sb=0 sd=0 mult=1 m=1
XM7 net14 ctl[9] bot vss sky130_fd_pr__nfet_g5v0d10v5 L=0.5 W=2 nf=1 ad='int((nf+1)/2) * W/nf * 0.29'
+ as='int((nf+2)/2) * W/nf * 0.29' pd='2*int((nf+1)/2) * (W/nf + 0.29)' ps='2*int((nf+2)/2) * (W/nf + 0.29)'
+ nrd='0.29 / W' nrs='0.29 / W' sa=0 sb=0 sd=0 mult=1 m=1
XM8 net13 ctl[8] bot vss sky130_fd_pr__nfet_g5v0d10v5 L=0.5 W=2 nf=1 ad='int((nf+1)/2) * W/nf * 0.29'
+ as='int((nf+2)/2) * W/nf * 0.29' pd='2*int((nf+1)/2) * (W/nf + 0.29)' ps='2*int((nf+2)/2) * (W/nf + 0.29)'
+ nrd='0.29 / W' nrs='0.29 / W' sa=0 sb=0 sd=0 mult=1 m=1
XM9 net6 ctl[5] bot vss sky130_fd_pr__nfet_g5v0d10v5 L=0.5 W=2 nf=1 ad='int((nf+1)/2) * W/nf * 0.29'
+ as='int((nf+2)/2) * W/nf * 0.29' pd='2*int((nf+1)/2) * (W/nf + 0.29)' ps='2*int((nf+2)/2) * (W/nf + 0.29)'
+ nrd='0.29 / W' nrs='0.29 / W' sa=0 sb=0 sd=0 mult=1 m=1
XM10 net5 ctl[4] bot vss sky130_fd_pr__nfet_g5v0d10v5 L=0.5 W=2 nf=1 ad='int((nf+1)/2) * W/nf * 0.29'
+ as='int((nf+2)/2) * W/nf * 0.29' pd='2*int((nf+1)/2) * (W/nf + 0.29)' ps='2*int((nf+2)/2) * (W/nf + 0.29)'
+ nrd='0.29 / W' nrs='0.29 / W' sa=0 sb=0 sd=0 mult=1 m=1
XM11 net7 ctl[6] bot vss sky130_fd_pr__nfet_g5v0d10v5 L=0.5 W=2 nf=1 ad='int((nf+1)/2) * W/nf * 0.29'
+ as='int((nf+2)/2) * W/nf * 0.29' pd='2*int((nf+1)/2) * (W/nf + 0.29)' ps='2*int((nf+2)/2) * (W/nf + 0.29)'
+ nrd='0.29 / W' nrs='0.29 / W' sa=0 sb=0 sd=0 mult=1 m=1
XM12 net8 ctl[7] bot vss sky130_fd_pr__nfet_g5v0d10v5 L=0.5 W=2 nf=1 ad='int((nf+1)/2) * W/nf * 0.29'
+ as='int((nf+2)/2) * W/nf * 0.29' pd='2*int((nf+1)/2) * (W/nf + 0.29)' ps='2*int((nf+2)/2) * (W/nf + 0.29)'
+ nrd='0.29 / W' nrs='0.29 / W' sa=0 sb=0 sd=0 mult=1 m=1
XM13 net3 ctl[2] bot vss sky130_fd_pr__nfet_g5v0d10v5 L=0.5 W=2 nf=1 ad='int((nf+1)/2) * W/nf * 0.29'
+ as='int((nf+2)/2) * W/nf * 0.29' pd='2*int((nf+1)/2) * (W/nf + 0.29)' ps='2*int((nf+2)/2) * (W/nf + 0.29)'
+ nrd='0.29 / W' nrs='0.29 / W' sa=0 sb=0 sd=0 mult=1 m=1
XM14 net2 ctl[1] bot vss sky130_fd_pr__nfet_g5v0d10v5 L=0.5 W=2 nf=1 ad='int((nf+1)/2) * W/nf * 0.29'
+ as='int((nf+2)/2) * W/nf * 0.29' pd='2*int((nf+1)/2) * (W/nf + 0.29)' ps='2*int((nf+2)/2) * (W/nf + 0.29)'
+ nrd='0.29 / W' nrs='0.29 / W' sa=0 sb=0 sd=0 mult=1 m=1
XM15 net1 ctl[0] bot vss sky130_fd_pr__nfet_g5v0d10v5 L=0.5 W=2 nf=1 ad='int((nf+1)/2) * W/nf * 0.29'
+ as='int((nf+2)/2) * W/nf * 0.29' pd='2*int((nf+1)/2) * (W/nf + 0.29)' ps='2*int((nf+2)/2) * (W/nf + 0.29)'
+ nrd='0.29 / W' nrs='0.29 / W' sa=0 sb=0 sd=0 mult=1 m=1
XM16 net4 ctl[3] bot vss sky130_fd_pr__nfet_g5v0d10v5 L=0.5 W=2 nf=1 ad='int((nf+1)/2) * W/nf * 0.29'
+ as='int((nf+2)/2) * W/nf * 0.29' pd='2*int((nf+1)/2) * (W/nf + 0.29)' ps='2*int((nf+2)/2) * (W/nf + 0.29)'
+ nrd='0.29 / W' nrs='0.29 / W' sa=0 sb=0 sd=0 mult=1 m=1
XR1 net12 top vss sky130_fd_pr__res_high_po W=1.41 L=2.8 mult=1 m=1
XR2 net11 net12 vss sky130_fd_pr__res_high_po W=1.41 L=2.8 mult=1 m=1
XR3 net10 net11 vss sky130_fd_pr__res_high_po W=1.41 L=2.8 mult=1 m=1
XR4 net9 net10 vss sky130_fd_pr__res_high_po W=1.41 L=2.8 mult=1 m=1
XR5 net15 net9 vss sky130_fd_pr__res_high_po W=1.41 L=2.8 mult=1 m=1
XR6 net14 net15 vss sky130_fd_pr__res_high_po W=1.41 L=2.8 mult=1 m=1
XR7 net13 net14 vss sky130_fd_pr__res_high_po W=1.41 L=2.8 mult=1 m=1
XR8 net8 net13 vss sky130_fd_pr__res_high_po W=1.41 L=2.8 mult=1 m=1
XR9 net7 net8 vss sky130_fd_pr__res_high_po W=1.41 L=2.8 mult=1 m=1
XR10 net6 net7 vss sky130_fd_pr__res_high_po W=1.41 L=2.8 mult=1 m=1
XR11 net5 net6 vss sky130_fd_pr__res_high_po W=1.41 L=2.8 mult=1 m=1
XR12 net4 net5 vss sky130_fd_pr__res_high_po W=1.41 L=2.8 mult=1 m=1
XR13 net3 net4 vss sky130_fd_pr__res_high_po W=1.41 L=2.8 mult=1 m=1
XR14 net2 net3 vss sky130_fd_pr__res_high_po W=1.41 L=2.8 mult=1 m=1
XR15 net1 net2 vss sky130_fd_pr__res_high_po W=1.41 L=2.8 mult=1 m=1
XR16 bot net1 vss sky130_fd_pr__res_high_po W=1.41 L=2.8 mult=1 m=1
.ends
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
